duarte-gui/homeguard/fotos/mapa-pads-esp32c3.png

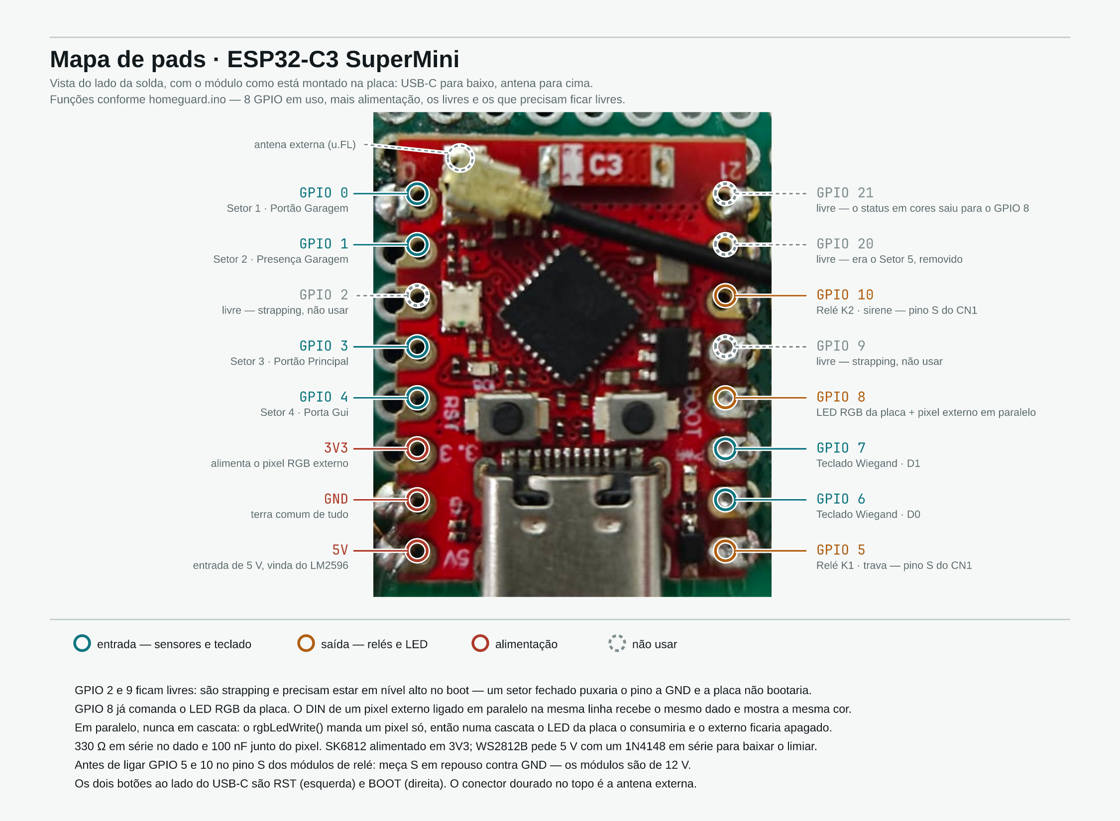
fotos/mapa-pads-esp32c3.png
