duarte-gui/homeguard/hardware/pcb/homeguard.kicad_pcb

## KiCad design hardware/pcb/homeguard.kicad_pcb (2026-10-24)

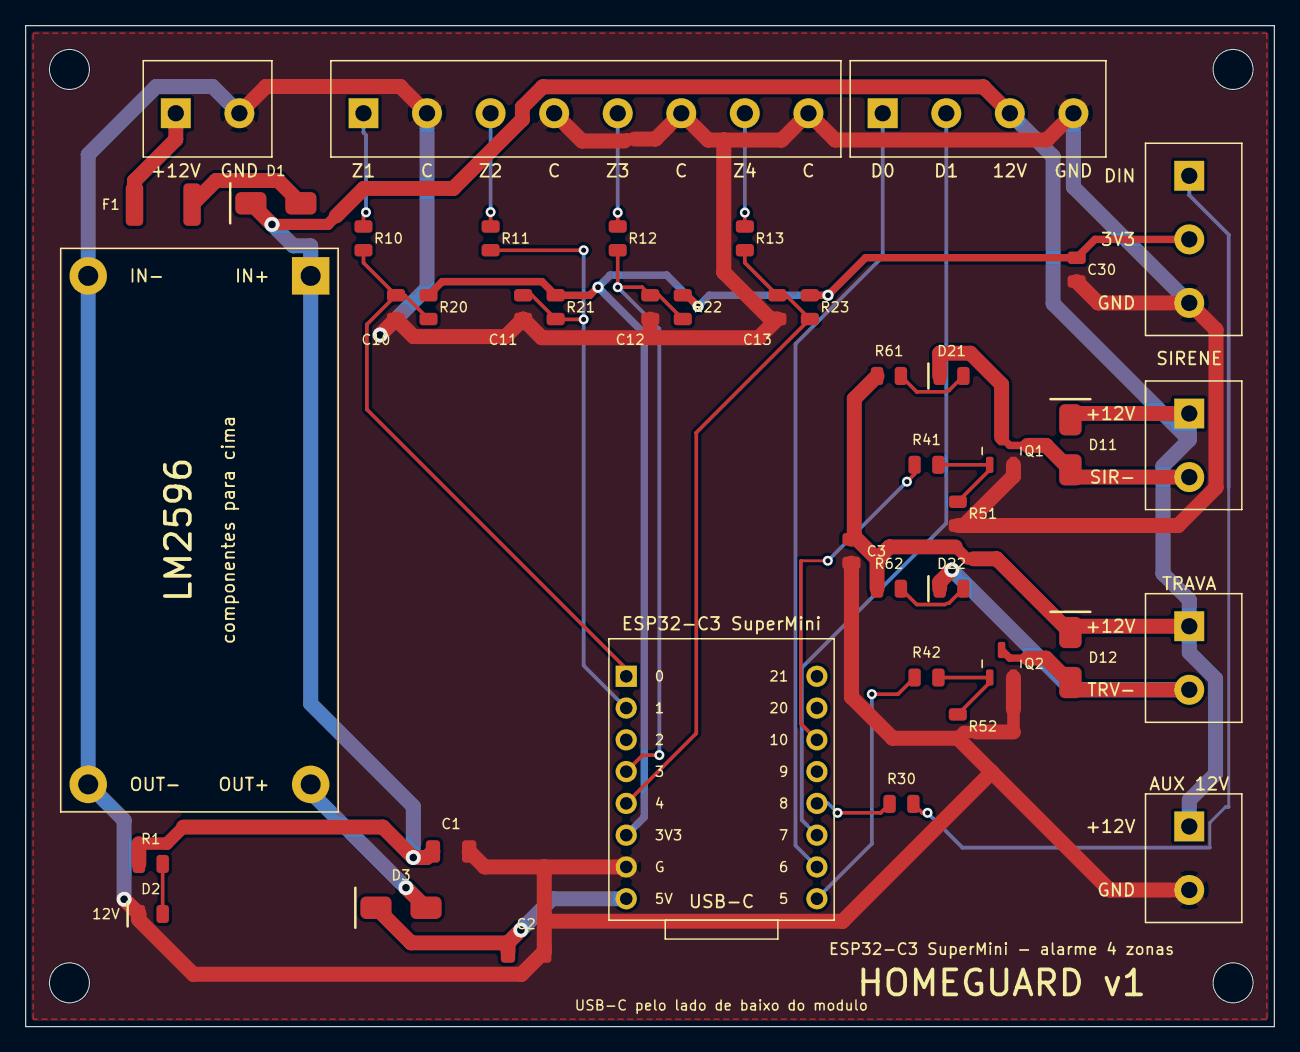
[picture p4: board homeguard.kicad_pcb from above]

Board: 2 copper layers, 99.8 x 80.0 mm, 48 parts (0 on the bottom side), 28 nets.

Parts:
C1, C2: 10uF 25V; C_1206
C3, C10, C11, C12, C13, C30: 100nF; C_0805
D1: SS54; D_SMA
D2: LED verde; LED_0805
D3: SS14; D_SMA
D11, D12: SS34; D_SMA
D21, D22: LED vermelho; LED_0805
F1: PTC 2A; Fuse_1812
H1, H2, H3, H4: M3; MountingHole_M3
J1: 12V; Terminal_5.08_2P
J2: ZONAS; Terminal_5.08_8P
J3: TECLADO; Terminal_5.08_4P
J4: RGB; Terminal_5.08_3P_V
J5: SIRENE; Terminal_5.08_2P_V
J6: TRAVA; Terminal_5.08_2P_V
J7, J8: 1x8 female; PinSocket_1x8_P2.54
J9: AUX 12V; Terminal_5.08_2P_V
Q1, Q2: AO3400A; SOT-23
R1: 4.7k; R_0805
R10, R11, R12, R13: 1k; R_0805
R20, R21, R22, R23: 10k; R_0805
R30: 330; R_0805
R41, R42: 100; R_0805
R51, R52: 100k; R_0805
R61, R62: 2.2k; R_0805
U2: LM2596 module; LM2596_Module

Connections:
+3V3: C30.1, J4.2, J7.6, R20.1, R21.1, R22.1, R23.1
+5V: C2.1, D3.1, J7.8
+5V_BUCK: D3.2, U2.4
+12V: C1.1, C3.1, D1.1, D11.1, D12.1, J3.3, J5.1, J6.1, J9.1, R1.1, R61.1, R62.1, U2.1
+12V_F: D1.2, F1.2
+12V_IN: F1.1, J1.1
GND: C1.2, C2.2, C3.2, C10.2, C11.2, C12.2, C13.2, C30.2, D2.1, J1.2, J2.2, J2.4, J2.6, J2.8, J3.4, J4.3, J7.7, J9.2, Q1.2, Q2.2, R51.2, R52.2, U2.2, U2.3
GPIO0: C10.1, J7.1, R10.2, R20.2
GPIO1: C11.1, J7.2, R11.2, R21.2
GPIO3: C12.1, J7.4, R12.2, R22.2
GPIO4: C13.1, J7.5, R13.2, R23.2
GPIO5: J8.8, R42.1
GPIO8: J8.5, R30.1
GPIO10: J8.3, R41.1
G_SIR: Q1.1, R41.2, R51.1
G_TRV: Q2.1, R42.2, R52.1
LED_12V: D2.2, R1.2
LED_SIR: D21.2, R61.2
LED_TRV: D22.2, R62.2
OUT_SIR: D11.2, D21.1, J5.2, Q1.3
OUT_TRV: D12.2, D22.1, J6.2, Q2.3
PIX_DIN: J4.1, R30.2
WG_D0: J3.1, J8.7
WG_D1: J3.2, J8.6
Z1_IN: J2.1, R10.1
Z2_IN: J2.3, R11.1
Z3_IN: J2.5, R12.1
Z4_IN: J2.7, R13.1
