duarte-gui/homeguard/(commit log)

2026-04-16 Corrige buffer overflow, substitui Tailwind CDN por build local e limpa arquivos vazios
    - homeguard.ino: corrige escrita fora dos limites no handler WebSocket usando
    deserializeJson com tamanho explícito ao invés de data[len]=0
    - data/: substitui <script src CDN tailwind> por build local via @tailwindcss/postcss,
    adiciona index.css e .postcssrc para gerar CSS bundlado offline (~19 KB)
    - Remove arquivos .tsx/tsconfig/vite.config vazios da raiz (artefatos do AI Studio)
    - .gitignore: exclui data/node_modules/, data/dist/ e data/.parcel-cache/
    [homeguard.ino]
2026-04-16 Adiciona README completo com dependências, pinagem e instruções de build/deploy
2026-06-10 feat: modulos NVS config + captive portal + gerencia de senhas
    - config.h: struct Config (rede/MQTT/Telegram/sirene) + KeypadCode
    - storage.*: persistencia em NVS (Preferences) p/ config e senhas
    - provisioning.*: portal hotspot (softAP+DNS+scan+save) estilo luminaria
    - codes.*: lista de senhas do teclado (add/remove/check), persistida
2026-06-10 feat: config via portal hotspot, estado triggered+LWT, sirene timeout/gating, cadastro de senhas
    - Remove segredos hardcoded: tudo vem da NVS (portal hotspot na 1a vez ou
    se o WiFi falhar). bot Telegram instanciado com a config.
    - Alarme publica estado triggered (entidade do HA deixa de ficar cega).
    - MQTT availability/LWT: entidades viram unavailable se o ESP cair.
    - Sirene: auto-corte por timeout (cfg.sirenTimeoutSec) e switch HA
    Sirene habilitada (gating) — permite alerta sem tocar a sirene fisica.
    - Cadastro de senhas: local (codigo valido + * entra no modo prog; nova
    senha + #) e remoto (MQTT homeguard/codes/set e WebSocket addCode/removeCode).
    - Comandos de sistema via MQTT: re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
2026-06-10 docs: README com portal de config, estado triggered, gating da sirene, cadastro de senhas e topicos MQTT
2026-06-10 feat(seguranca): senha mestre p/ programar o teclado + README com pre-requisitos
    - Portal coleta SENHA MESTRE (obrigatoria); vira tb o PIN de desarme do HA.
    - So a mestre programa o teclado (corrige vulnerabilidade: antes qualquer
    senha valida entrava no modo programacao).
    - Teclado: * preservado (limpa digitos). Programacao entra por # com buffer
    VAZIO -> mestre + # -> menu 1=cadastrar 2=remover 0=reset. Maquina de
    estados (KP_IDLE/AUTH/MENU/ADD/DEL/RESET).
    - README: secao Pre-requisitos no inicio (Wi-Fi, MQTT/Mosquitto, senha mestre,
    Telegram via BotFather/userinfobot) com passo a passo de como obter cada dado.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
    [config.h, homeguard.ino, provisioning.cpp, storage.cpp]
2026-08-19 fix(build): corrige config do VS Code, particao huge_app e docs desatualizadas
    O .vscode/c_cpp_properties.json vinha de outra maquina: todos os caminhos
    apontavam para /home/tecnologia, core 3.3.0 e pastas de lib com nomes
    antigos (ESPAsyncWebServer-master, AsyncTCP-master). Nenhum include
    resolvia, e faltavam WebServer/DNSServer/Preferences, exigidos pelos
    modulos novos de provisioning e storage.
    - c_cpp_properties.json regenerado a partir da compilation database real
    (arduino-cli --only-compilation-database), com ${env:HOME} no lugar de
    caminho absoluto e o bloco de ~400 defines do compilador removido —
    cptools obtem isso do compilerPath.
    - .vscode/settings.json: associa *.ino a C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
2026-10-24 feat(c3): migra o firmware para o ESP32-C3 SuperMini
    - mapa de pinos do C3 (setores 0/1/3/4/20, rele 5/10, LED 21, Wiegand 6/7),
    fugindo da flash interna, da USB e dos pinos de strapping
    - LED RGB embutido (GPIO 8) mostra disparo, Wi-Fi caido e estado de armado
    - mDNS: acesso por http://homeguard.local
    - LittleFS deixa de travar o boot: sem ele, so a interface web fica fora
    - flash.sh detecta o chip conectado e grava com o offset certo
    - config do VS Code e README para o novo alvo
2026-10-24 fix: Wi-Fi do portal, comandos MQTT retidos e 4 setores
    Portal de configuracao
    - a varredura roda ANTES de subir o hotspot: com o AP no ar e um celular
    conectado, o radio fica preso no canal do AP e a lista vinha vazia
    - resultados acumulados entre varreduras, botao "Procurar de novo",
    campo para rede oculta, "mostrar senha" e aviso de espaco na senha
    Wi-Fi
    - falha de conexao agora diz o motivo pelo reason code do driver
    (senha errada, rede nao encontrada, AP recusou...)
    - setHostname antes do WiFi.mode(), como o core 3.x exige
    MQTT
    - apaga mensagens retidas nos topicos de comando antes do subscribe:
    um ON retido disparava a sirene em todo boot
    - ignora payload vazio (desabilitava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
    [Wiegand.cpp, homeguard.ino, provisioning.cpp]
2026-10-24 feat(hardware): placa de circuito impresso para o ESP32-C3 SuperMini
    Placa de 2 camadas, 99,8 x 80 mm (cabe na faixa de preco de ate 100 mm),
    pronta para fabricacao e montagem (Gerber, BOM e arquivo de posicao em
    hardware/pcb/fabricacao/).
    - SuperMini em soquete (2 barras femea 1x8, fileiras a 15,24 mm)
    - entrada 12 V com PTC e diodo contra inversao; LM2596 em modulo,
    furos a 40,64 x 17,78 mm, sem cobre sob ele
    - 4 zonas com 1k em serie, pull-up 10k e 100 nF
    - sirene e trava por MOSFET AO3400A (fecha com 3,3 V), pull-down no gate,
    flyback e LED indicador
    - bornes para teclado Wiegand, pixel RGB e 12 V auxiliar
    - gerar_placa.py descreve a placa; rotear.py roteia com FreeRouting,
    roda o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
    [homeguard-B_Cu.gbr, homeguard-B_Mask.gbr, homeguard-B_Paste.gbr, homeguard-B_Silkscreen.gbr, homeguard-Edge_Cuts.gbr, homeguard-F_Cu.gbr, homeguard-F_Mask.gbr, homeguard-F_Paste.gbr]
2026-10-24 docs: mapa de pads do ESP32-C3 SuperMini
    Funcao de cada pino do modulo sobre a foto da placa, com os pinos que
    precisam ficar livres (strapping, USB) marcados.
2026-10-25 feat: admin web, modos de arme, tipos de zona, OTA e registro de eventos (v2.2.1)
    Firmware
    - Página de admin (senha mestre): zonas (nome, tipo, Em casa, inibir), senhas e
    senha de pânico, tempos, arme automático, sirene, Telegram, rede, backup e
    restauração, registro de eventos e atualização do firmware pela rede.
    - Modos Ausente e Em casa, também no painel do Home Assistant.
    - Zonas instantânea, entrada/saída (tempo de entrada e saída), seguidora e 24 h.
    - Aviso ao armar com zona aberta; teclado e HA armam inibindo a zona até desarmar.
    - Continua armado depois de falta de energia.
    - Registro dos últimos 200 eventos no LittleFS, com horário por NTP.
    - OTA com volta automát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
2026-10-25 feat(tools): homeguard-admin, administração pelo terminal
    Programa em Rust (ratatui) que faz tudo o que a página de admin faz e mais:
    - acha as placas na rede (mDNS e varredura das redes /24, via /api/info);
    - grava pelo cabo USB sem Python nem esptool (bootloader, partições e
    boot_app0 embutidos; só o homeguard.ino.bin é escolhido), mostrando quando
    o ESP32 é plugado ou tirado;
    - atualiza pela rede (OTA) e baixa o firmware do último release do GitHub;
    - modo linha de comando: --scan, --flash, --download.
    tools/release.sh compila e publica o release com o homeguard.ino.bin.
2026-10-25 fix: correções da revisão do firmware
    - Hotspot de resgate: /setup redirecionava para si mesmo (a rota "/setup"
    casava também com "/setup/..."). Agora exata, e as páginas do hotspot só
    respondem a quem está nele.
    - MQTT: cadastrar senha e reset de fábrica exigem a senha mestre (antes quem
    publicava no broker criava uma senha e desarmava).
    - Armar não apaga mais um disparo (zona 24 h): só o desarme, com senha.
    - Telegram numa tarefa própria: o envio (TLS, até 8 s por mensagem) travava a
    leitura das zonas e do teclado. A fila espera a rede voltar sem perder avisos.
    - Senha mestre com limite de tentativas próprio (um acerto de senha comum zerava
    o contador) e contagem seg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
    [config.h, homeguard.ino, storage.cpp, storage.h]
